isabel2025/CapstoneProject/machine-learning/README.md

# AQI prediction model

The notebook trains a `RandomForestRegressor` to predict AQI from:

- PM2.5
- CO2
- VOCs
- temperature
- humidity

The capstone report records an 80/20 train-test split with an MSE of 35.67 and an R² of 0.987.

The training dataset is not included in the public repository.
