isabel2025/CapstoneProject/mobile-app/prototype/README.md

# Flutter app prototype

This is an early Flutter prototype used while testing the sensor-to-database-to-app flow.

It fetches readings from the PHP API and displays sensor values in the app. This version also contains an MQ-3 experiment from an earlier development stage.

The server address has been replaced with a placeholder for publishing.
