isabel2025/CapstoneProject/web-dashboard/prototype/README.md

# Web dashboard prototype

A simple browser dashboard used during development to view live sensor readings.

It reads data from the PHP JSON endpoint, displays the latest records in a table, and plots temperature and humidity with Chart.js.
