isabel2025/CapstoneProject/(commit log)

2026-09-30 Add backend/prototype/README.md
2026-09-30 Add backend/prototype/schema.sql
2026-09-30 Add backend/prototype/upload_data.php
2026-09-30 Add backend/prototype/view_data.php
2026-09-30 Add web-dashboard/prototype/README.md
2026-09-30 Add web-dashboard/prototype/index.html
2026-09-30 Add mobile-app/prototype/README.md
2026-09-30 Add mobile-app/prototype/pubspec.yaml
2026-09-30 Add mobile-app/prototype/lib/main.dart
2026-09-30 Add mobile-app/prototype/lib/models/sensor_data.dart
2026-09-30 Add mobile-app/prototype/lib/services/api_service.dart
2026-09-30 Remove unverified dataset from portfolio branch
    [aqi_dataset.csv]
